haldean/droidcopter/text/spring/figures/firstrunpngs/motor1.png

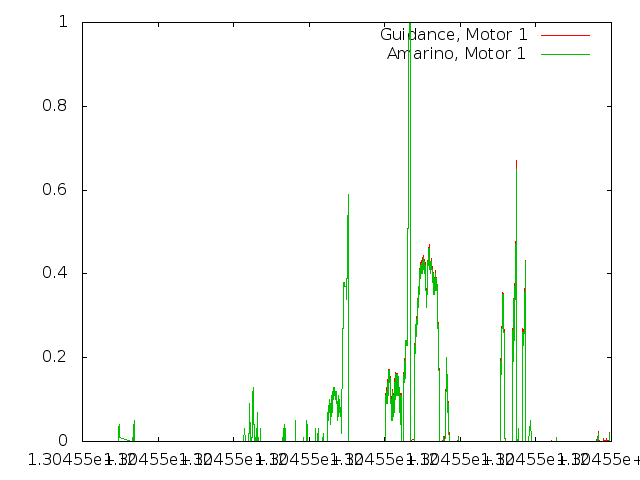
text/spring/figures/firstrunpngs/motor1.png
