haldean/droidcopter/text/spring/figures/firstrunpngs/motor3.png

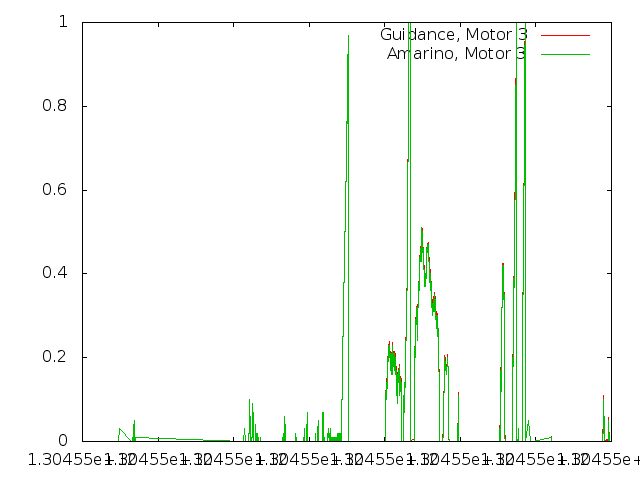
text/spring/figures/firstrunpngs/motor3.png
