haldean/droidcopter/models/stl/stanley.stl

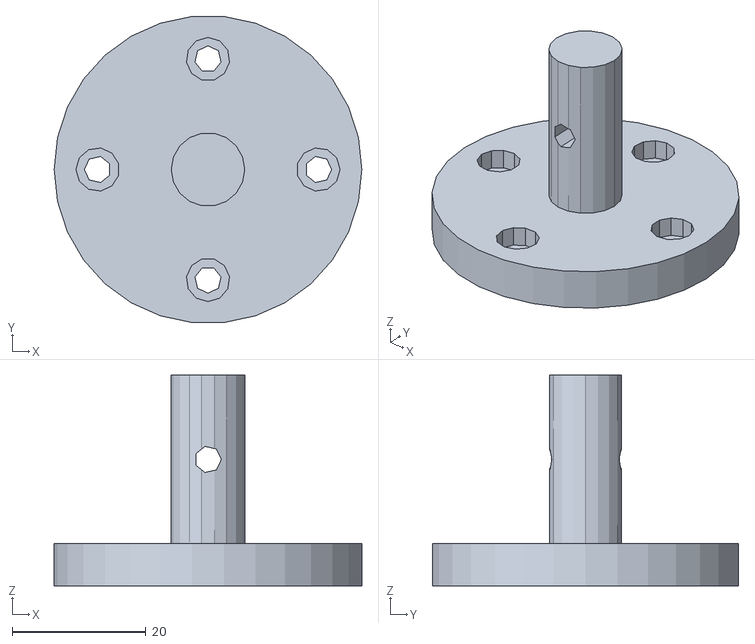
[picture p12: CAD file, 2010-12-11]
models/stl/stanley.stl
46.0 x 45.7 x 31.5
