haldean/droidcopter/models/stl/fred_extended.stl

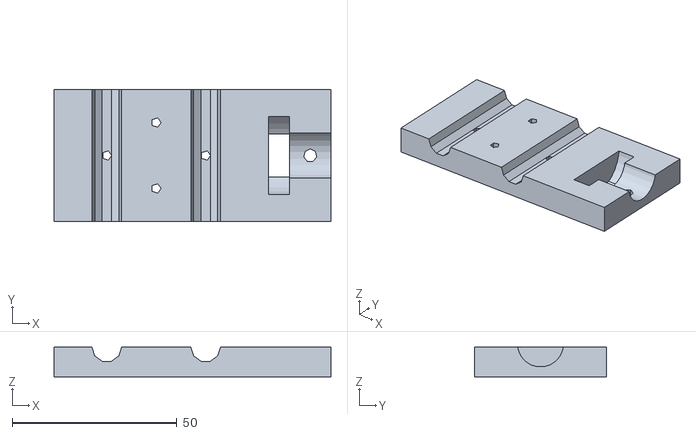
[picture p13: CAD file, 2010-11-23]
models/stl/fred_extended.stl
84.0 x 40.0 x 9.00
