haldean/droidcopter/models/stl/benedict.stl

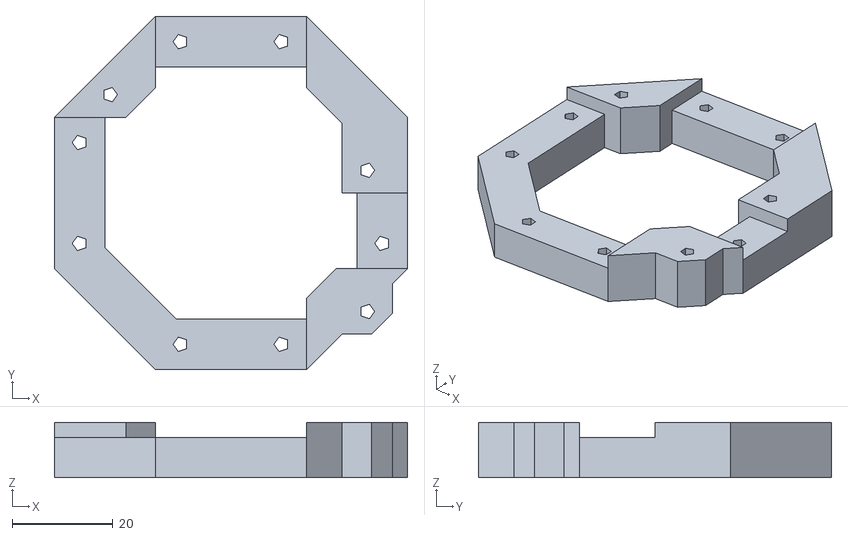
[picture p14: CAD file, 2010-11-23]
models/stl/benedict.stl
70.0 x 70.0 x 11.0
