haldean/droidcopter/models/stl/brock_a.stl

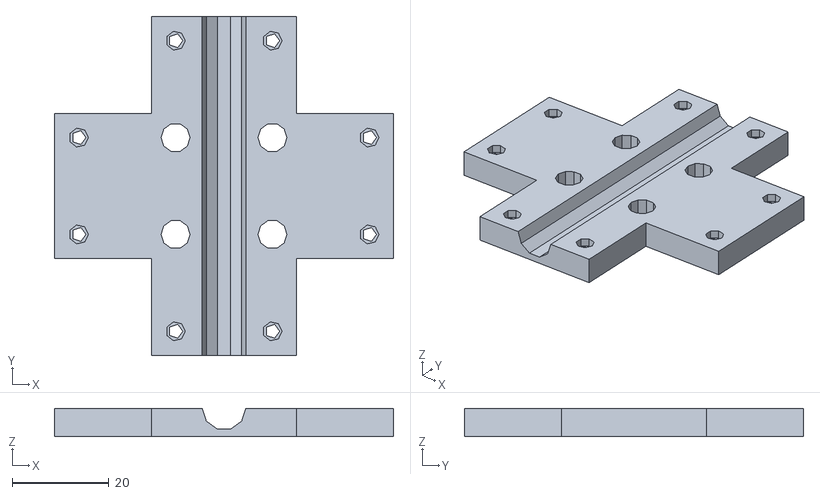
[picture p15: CAD file, 2010-11-23]
models/stl/brock_a.stl
70.0 x 70.0 x 5.85
