haldean/droidcopter/models/stl/brock_b.stl

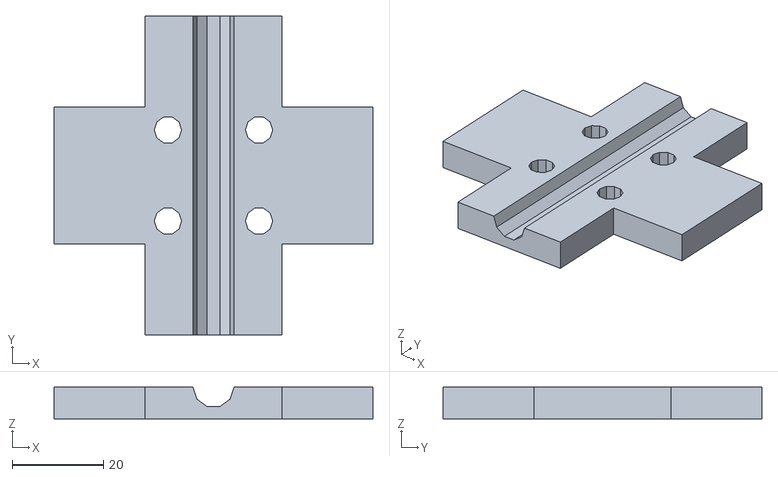
[picture p16: CAD file, 2010-11-23]
models/stl/brock_b.stl
70.0 x 70.0 x 7.00
