haldean/droidcopter/models/stl/fred.stl

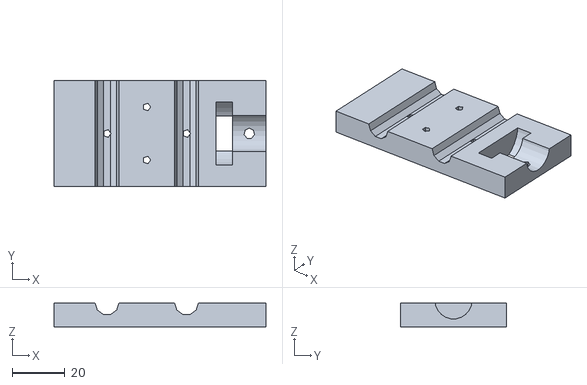
[picture p17: CAD file, 2010-11-23]
models/stl/fred.stl
80.0 x 40.0 x 9.00
