haldean/droidcopter/models/scad/fred_extended.scad

include <hardware.scad>
use <stanley.scad>

module fred() {
	h = 2 * axle_r;
	extension = 4; 
	difference() {
		cube([80 + extension, 40, h]);

		translate(v=[20 - extension, -10, h]) axlepair();

		translate(v=[80 + extension, 20, 10]) {
			rotate(v=[1,0,0], 90) 
				rotate(v=[0,1,0], 90) stanley(solid_screw=true);
		}

		for (v = [[20 - extension + axle_separation/2, 10, 0],
				[20 - extension + axle_separation/2, 30, 0]])
			translate(v=v) m2();

		for (v = [[20 - extension,20,0],
				[20 - extension + axle_separation,20,0]])
			translate(v=v) m2();
	}
}

fred();
