haldean/droidcopter/(list of files, cad)

Other CAD files:
models/scad/axle.scad
models/scad/brock_a.scad
models/scad/brock_b.scad
