haldean/droidcopter/jars/worldwind/src/gov/nasa/worldwind/layers/AbstractGraticuleLayer.java

/*
Copyright (C) 2001, 2009 United States Government
as represented by the Administrator of the
National Aeronautics and Space Administration.
All Rights Reserved.
*/
package gov.nasa.worldwind.layers;

import gov.nasa.worldwind.View;
import gov.nasa.worldwind.avlist.*;
import gov.nasa.worldwind.geom.*;
import gov.nasa.worldwind.globes.Globe;
import gov.nasa.worldwind.render.*;
import gov.nasa.worldwind.util.*;
import gov.nasa.worldwind.view.orbit.OrbitView;

import java.awt.*;
import java.util.*;

/**
 * Displays a graticule.
 *
 * @author Patrick Murris
 * @version $Id$
 */
public class AbstractGraticuleLayer extends AbstractLayer
{
    /**
     * Solid line rendering style. This style specifies that a line will be drawn without any breaks. <br>
     * <pre><code>_________</code></pre>
     * <br> is an example of a solid line.
     */
    public static final String LINE_STYLE_SOLID = GraticuleRenderingParams.VALUE_LINE_STYLE_SOLID;
    /**
     * Dashed line rendering style. This style specifies that a line will be drawn as a series of long strokes, with
     * space in between. <br>
     * <pre><code>- - - - -</code></pre>
     * <br> is an example of a dashed line.
     */
    public static final String LINE_STYLE_DASHED = GraticuleRenderingParams.VALUE_LINE_STYLE_DASHED;
    /**
     * Dotted line rendering style. This style specifies that a line will be drawn as a series of evenly spaced "square"
     * dots. <br>
     * <pre><code>. . . . .</code></pre>
     * is an example of a dotted line.
     */
    public static final String LINE_STYLE_DOTTED = GraticuleRenderingParams.VALUE_LINE_STYLE_DOTTED;

    protected ArrayList<GridElement> gridElements;
    protected GraticuleSupport graticuleSupport = new GraticuleSupport();
    protected double polylineTerrainConformance = 50;
    protected Frustum viewFrustum;
    protected Globe globe;
    protected boolean useSurfaceShapes = false; // TODO: Set to true for Surface polyline test

    // Update reference states
    protected Vec4 lastEyePoint;
    protected double lastViewHeading = 0;
    protected double lastViewPitch = 0;
    protected double lastViewFOV = 0;
    protected double lastVerticalExaggeration = 1;

    public AbstractGraticuleLayer()
    {
    }

    /**
     * Returns whether or not graticule lines will be rendered.
     *
     * @param key the rendering parameters key.
     *
     * @return true if graticule lines will be rendered; false otherwise.
     *
     * @throws IllegalArgumentException <code>key</code> is null.
     */
    public boolean isDrawGraticule(String key)
    {
        if (key == null)
        {
            String message = Logging.getMessage("nullValue.StringIsNull");
            Logging.logger().severe(message);
            throw new IllegalArgumentException(message);
        }
        return getRenderingParams(key).isDrawLines();
    }

    /**
     * Sets whether or not graticule lines will be rendered.
     *
     * @param drawGraticule true to render graticule lines; false to disable rendering.
     * @param key           the rendering parameters key.
     *
     * @throws IllegalArgumentException <code>key</code> is null.
     */
    public void setDrawGraticule(boolean drawGraticule, String key)
    {
        if (key == null)
        {
            String message = Logging.getMessage("nullValue.StringIsNull");
            Logging.logger().severe(message);
            throw new IllegalArgumentException(message);
        }
        getRenderingParams(key).setDrawLines(drawGraticule);
    }

    /**
     * Returns the graticule line Color.
     *
     * @param key the rendering parameters key.
     *
     * @return Color used to render graticule lines.
     *
     * @throws IllegalArgumentException <code>key</code> is null.
     */
    public Color getGraticuleLineColor(String key)
    {
        if (key == null)
        {
            String message = Logging.getMessage("nullValue.StringIsNull");
            Logging.logger().severe(message);
            throw new IllegalArgumentException(message);
        }
        return getRenderingParams(key).getLineColor();
    }

    /**
     * Sets the graticule line Color.
     *
     * @param color Color that will be used to render graticule lines.
     * @param key   the rendering parameters key.
     *
     * @throws IllegalArgumentException if <code>color</code> or <code>key</code> is null.
     */
    public void setGraticuleLineColor(Color color, String key)
    {
        if (color == null)
        {
            String message = Logging.getMessage("nullValue.ColorIsNull");
            Logging.logger().severe(message);
            throw new IllegalArgumentException(message);
        }
        if (key == null)
        {
            String message = Logging.getMessage("nullValue.StringIsNull");
            Logging.logger().severe(message);
            throw new IllegalArgumentException(message);
        }

        getRenderingParams(key).setLineColor(color);
    }

    /**
     * Returns the graticule line width.
     *
     * @param key the rendering parameters key.
     *
     * @return width of the graticule lines.
     *
     * @throws IllegalArgumentException <code>key</code> is null.
     */
    public double getGraticuleLineWidth(String key)
    {
        if (key == null)
        {
            String message = Logging.getMessage("nullValue.StringIsNull");
            Logging.logger().severe(message);
            throw new IllegalArgumentException(message);
        }
        return getRenderingParams(key).getLineWidth();
    }

    /**
     * Sets the graticule line width.
     *
     * @param lineWidth width of the graticule lines.
     * @param key       the rendering parameters key.
     *
     * @throws IllegalArgumentException <code>key</code> is null.
     */
    public void setGraticuleLineWidth(double lineWidth, String key)
    {
        if (key == null)
        {
            String message = Logging.getMessage("nullValue.StringIsNull");
            Logging.logger().severe(message);
            throw new IllegalArgumentException(message);
        }
        getRenderingParams(key).setLineWidth(lineWidth);
    }

    /**
     * Returns the graticule line rendering style.
     *
     * @param key the rendering parameters key.
     *
     * @return rendering style of the graticule lines.
     *
     * @throws IllegalArgumentException <code>key</code> is null.
     */
    public String getGraticuleLineStyle(String key)
    {
        if (key == null)
        {
            String message = Logging.getMessage("nullValue.StringIsNull");
            Logging.logger().severe(message);
            throw new IllegalArgumentException(message);
        }
        return getRenderingParams(key).getLineStyle();
    }

    /**
     * Sets the graticule line rendering style.
     *
     * @param lineStyle rendering style of the graticule lines. One of LINE_STYLE_PLAIN, LINE_STYLE_DASHED, or
     *                  LINE_STYLE_DOTTED.
     * @param key       the rendering parameters key.
     *
     * @throws IllegalArgumentException if <code>lineStyle</code> or <code>key</code> is null.
     */
    public void setGraticuleLineStyle(String lineStyle, String key)
    {
        if (lineStyle == null)
        {
            String message = Logging.getMessage("nullValue.StringIsNull");
            Logging.logger().severe(message);
            throw new IllegalArgumentException(message);
        }
        if (key == null)
        {
            String message = Logging.getMessage("nullValue.StringIsNull");
            Logging.logger().severe(message);
            throw new IllegalArgumentException(message);
        }

        getRenderingParams(key).setLineStyle(lineStyle);
    }

    /**
     * Returns whether or not graticule labels will be rendered.
     *
     * @param key the rendering parameters key.
     *
     * @return true if graticule labels will be rendered; false otherwise.
     *
     * @throws IllegalArgumentException <code>key</code> is null.
     */
    public boolean isDrawLabels(String key)
    {
        if (key == null)
        {
            String message = Logging.getMessage("nullValue.StringIsNull");
            Logging.logger().severe(message);
            throw new IllegalArgumentException(message);
        }
        return getRenderingParams(key).isDrawLabels();
    }

    /**
     * Sets whether or not graticule labels will be rendered.
     *
     * @param drawLabels true to render graticule labels; false to disable rendering.
     * @param key        the rendering parameters key.
     *
     * @throws IllegalArgumentException <code>key</code> is null.
     */
    public void setDrawLabels(boolean drawLabels, String key)
    {
        if (key == null)
        {
            String message = Logging.getMessage("nullValue.StringIsNull");
            Logging.logger().severe(message);
            throw new IllegalArgumentException(message);
        }
        getRenderingParams(key).setDrawLabels(drawLabels);
    }

    /**
     * Returns the graticule label Color.
     *
     * @param key the rendering parameters key.
     *
     * @return Color used to render graticule labels.
     *
     * @throws IllegalArgumentException <code>key</code> is null.
     */
    public Color getLabelColor(String key)
    {
        if (key == null)
        {
            String message = Logging.getMessage("nullValue.StringIsNull");
            Logging.logger().severe(message);
            throw new IllegalArgumentException(message);
        }
        return getRenderingParams(key).getLabelColor();
    }

    /**
     * Sets the graticule label Color.
     *
     * @param color Color that will be used to render graticule labels.
     * @param key   the rendering parameters key.
     *
     * @throws IllegalArgumentException if <code>color</code> or <code>key</code> is null.
     */
    public void setLabelColor(Color color, String key)
    {
        if (color == null)
        {
            String message = Logging.getMessage("nullValue.ColorIsNull");
            Logging.logger().severe(message);
            throw new IllegalArgumentException(message);
        }
        if (key == null)
        {
            String message = Logging.getMessage("nullValue.StringIsNull");
            Logging.logger().severe(message);
            throw new IllegalArgumentException(message);
        }

        getRenderingParams(key).setLabelColor(color);
    }

    /**
     * Returns the Font used for graticule labels.
     *
     * @param key the rendering parameters key.
     *
     * @return Font used to render graticule labels.
     *
     * @throws IllegalArgumentException <code>key</code> is null.
     */
    public Font getLabelFont(String key)
    {
        if (key == null)
        {
            String message = Logging.getMessage("nullValue.StringIsNull");
            Logging.logger().severe(message);
            throw new IllegalArgumentException(message);
        }
        return getRenderingParams(key).getLabelFont();
    }

    /**
     * Sets the Font used for graticule labels.
     *
     * @param font Font that will be used to render graticule labels.
     * @param key  the rendering parameters key.
     *
     * @throws IllegalArgumentException if <code>font</code> or <code>key</code> is null.
     */
    public void setLabelFont(Font font, String key)
    {
        if (font == null)
        {
            String message = Logging.getMessage("nullValue.FontIsNull");
            Logging.logger().severe(message);
            throw new IllegalArgumentException(message);
        }
        if (key == null)
        {
            String message = Logging.getMessage("nullValue.StringIsNull");
            Logging.logger().severe(message);
            throw new IllegalArgumentException(message);
        }

        getRenderingParams(key).setLabelFont(font);
    }

    public String getRestorableState()
    {
        RestorableSupport rs = RestorableSupport.newRestorableSupport();
        // Creating a new RestorableSupport failed. RestorableSupport logged the problem, so just return null.
        if (rs == null)
            return null;

        RestorableSupport.StateObject so = rs.addStateObject("renderingParams");
        for (Map.Entry<String, GraticuleRenderingParams> entry : this.graticuleSupport.getAllRenderingParams())
        {
            if (entry.getKey() != null && entry.getValue() != null)
            {
                RestorableSupport.StateObject eso = rs.addStateObject(so, entry.getKey());
                makeRestorableState(entry.getValue(), rs, eso);
            }
        }

        return rs.getStateAsXml();
    }

    private static void makeRestorableState(AVList params, RestorableSupport rs, RestorableSupport.StateObject context)
    {
        if (params != null && rs != null)
        {
            for (Map.Entry<String, Object> p : params.getEntries())
            {
                if (p.getValue() instanceof Color)
                {
                    rs.addStateValueAsInteger(context, p.getKey() + ".Red", ((Color) p.getValue()).getRed());
                    rs.addStateValueAsInteger(context, p.getKey() + ".Green", ((Color) p.getValue()).getGreen());
                    rs.addStateValueAsInteger(context, p.getKey() + ".Blue", ((Color) p.getValue()).getBlue());
                    rs.addStateValueAsInteger(context, p.getKey() + ".Alpha", ((Color) p.getValue()).getAlpha());
                }
                else if (p.getValue() instanceof Font)
                {
                    rs.addStateValueAsString(context, p.getKey() + ".Name", ((Font) p.getValue()).getName());
                    rs.addStateValueAsInteger(context, p.getKey() + ".Style", ((Font) p.getValue()).getStyle());
                    rs.addStateValueAsInteger(context, p.getKey() + ".Size", ((Font) p.getValue()).getSize());
                }
                else
                {
                    rs.addStateValueAsString(context, p.getKey(), p.getValue().toString());
                }
            }
        }
    }

    public void restoreState(String stateInXml)
    {
        if (stateInXml == null)
        {
            String message = Logging.getMessage("nullValue.StringIsNull");
            Logging.logger().severe(message);
            throw new IllegalArgumentException(message);
        }

        RestorableSupport rs;
        try
        {
            rs = RestorableSupport.parse(stateInXml);
        }
        catch (Exception e)
        {
            // Parsing the document specified by stateInXml failed.
            String message = Logging.getMessage("generic.ExceptionAttemptingToParseStateXml", stateInXml);
            Logging.logger().severe(message);
            throw new IllegalArgumentException(message, e);
        }

        RestorableSupport.StateObject so = rs.getStateObject("renderingParams");
        if (so != null)
        {
            RestorableSupport.StateObject[] renderParams = rs.getAllStateObjects(so);
            for (RestorableSupport.StateObject rp : renderParams)
            {
                if (rp != null)
                {
                    GraticuleRenderingParams params = getRenderingParams(rp.getName());
                    if (params == null)
                        params = new GraticuleRenderingParams();
                    restorableStateToParams(params, rs, rp);
                    setRenderingParams(rp.getName(), params);
                }
            }
        }
    }

    private static void restorableStateToParams(AVList params, RestorableSupport rs,
        RestorableSupport.StateObject context)
    {
        if (params != null && rs != null)
        {
            Boolean b = rs.getStateValueAsBoolean(context, GraticuleRenderingParams.KEY_DRAW_LINES);
            if (b != null)
                params.setValue(GraticuleRenderingParams.KEY_DRAW_LINES, b);

            Integer red = rs.getStateValueAsInteger(context, GraticuleRenderingParams.KEY_LINE_COLOR + ".Red");
            Integer green = rs.getStateValueAsInteger(context, GraticuleRenderingParams.KEY_LINE_COLOR + ".Green");
            Integer blue = rs.getStateValueAsInteger(context, GraticuleRenderingParams.KEY_LINE_COLOR + ".Blue");
            Integer alpha = rs.getStateValueAsInteger(context, GraticuleRenderingParams.KEY_LINE_COLOR + ".Alpha");
            if (red != null && green != null && blue != null && alpha != null)
                params.setValue(GraticuleRenderingParams.KEY_LINE_COLOR, new Color(red, green, blue, alpha));

            Double d = rs.getStateValueAsDouble(context, GraticuleRenderingParams.KEY_LINE_WIDTH);
            if (d != null)
                params.setValue(GraticuleRenderingParams.KEY_LINE_WIDTH, d);

            String s = rs.getStateValueAsString(context, GraticuleRenderingParams.KEY_LINE_STYLE);
            if (s != null)
                params.setValue(GraticuleRenderingParams.KEY_LINE_STYLE, s);

            b = rs.getStateValueAsBoolean(context, GraticuleRenderingParams.KEY_DRAW_LABELS);
            if (b != null)
                params.setValue(GraticuleRenderingParams.KEY_DRAW_LABELS, b);

            red = rs.getStateValueAsInteger(context, GraticuleRenderingParams.KEY_LABEL_COLOR + ".Red");
            green = rs.getStateValueAsInteger(context, GraticuleRenderingParams.KEY_LABEL_COLOR + ".Green");
            blue = rs.getStateValueAsInteger(context, GraticuleRenderingParams.KEY_LABEL_COLOR + ".Blue");
            alpha = rs.getStateValueAsInteger(context, GraticuleRenderingParams.KEY_LABEL_COLOR + ".Alpha");
            if (red != null && green != null && blue != null && alpha != null)
                params.setValue(GraticuleRenderingParams.KEY_LABEL_COLOR, new Color(red, green, blue, alpha));

            String name = rs.getStateValueAsString(context, GraticuleRenderingParams.KEY_LABEL_FONT + ".Name");
            Integer style = rs.getStateValueAsInteger(context, GraticuleRenderingParams.KEY_LABEL_FONT + ".Style");
            Integer size = rs.getStateValueAsInteger(context, GraticuleRenderingParams.KEY_LABEL_FONT + ".Size");
            if (name != null && style != null && size != null)
                params.setValue(GraticuleRenderingParams.KEY_LABEL_FONT, new Font(name, style, size));
        }
    }

    // --- Graticule Rendering --------------------------------------------------------------

    protected GraticuleRenderingParams getRenderingParams(String key)
    {
        if (key == null)
        {
            String message = Logging.getMessage("nullValue.KeyIsNull");
            Logging.logger().severe(message);
            throw new IllegalArgumentException(message);
        }

        return this.graticuleSupport.getRenderingParams(key);
    }

    protected void setRenderingParams(String key, GraticuleRenderingParams renderingParams)
    {
        if (key == null)
        {
            String message = Logging.getMessage("nullValue.KeyIsNull");
            Logging.logger().severe(message);
            throw new IllegalArgumentException(message);
        }

        this.graticuleSupport.setRenderingParams(key, renderingParams);
    }

    protected void addRenderable(Object renderable, String paramsKey)
    {
        if (renderable == null)
        {
            String message = Logging.getMessage("nullValue.ObjectIsNull");
            Logging.logger().severe(message);
            throw new IllegalArgumentException(message);
        }

        this.graticuleSupport.addRenderable(renderable, paramsKey);
    }

    protected void removeAllRenderables()
    {
        this.graticuleSupport.removeAllRenderables();
    }

    public void doPreRender(DrawContext dc)
    {
        if (dc == null)
        {
            String message = Logging.getMessage("nullValue.DrawContextIsNull");
            Logging.logger().severe(message);
            throw new IllegalArgumentException(message);
        }
        if (this.needsToUpdate(dc))
        {
            // Init frame
            this.clear(dc);

            // Select renderables
            this.selectRenderables(dc);
        }
        // Pre render
        this.preRenderGraticule(dc);
    }

    public void doRender(DrawContext dc)
    {
        if (dc == null)
        {
            String message = Logging.getMessage("nullValue.DrawContextIsNull");
            Logging.logger().severe(message);
            throw new IllegalArgumentException(message);
        }

        // Render
        this.renderGraticule(dc);
    }

    protected void preRenderGraticule(DrawContext dc)
    {
        if (dc == null)
        {
            String message = Logging.getMessage("nullValue.DrawContextIsNull");
            Logging.logger().severe(message);
            throw new IllegalArgumentException(message);
        }

        this.graticuleSupport.preRender(dc, this.getOpacity());
    }

    protected void renderGraticule(DrawContext dc)
    {
        if (dc == null)
        {
            String message = Logging.getMessage("nullValue.DrawContextIsNull");
            Logging.logger().severe(message);
            throw new IllegalArgumentException(message);
        }

        this.graticuleSupport.render(dc, this.getOpacity());
    }

    /**
     * Select the visible grid elements
     *
     * @param dc the current <code>DrawContext</code>.
     */
    protected void selectRenderables(DrawContext dc)
    {
        if (dc == null)
        {
            String message = Logging.getMessage("nullValue.DrawContextIsNull");
            Logging.logger().severe(message);
            throw new IllegalArgumentException(message);
        }

        // This method is intended to be overriden by subclasses

    }

    /**
     * Determines whether the grid should be updated. It returns true if: <ul> <li>the eye has moved more than 1% of its
     * altitude above ground <li>the view FOV, heading or pitch have changed more than 1 degree <li>vertical
     * exaggeration has changed </ul
     *
     * @param dc the current <code>DrawContext</code>.
     *
     * @return true if the graticule should be updated.
     */
    @SuppressWarnings({"RedundantIfStatement"})
    protected boolean needsToUpdate(DrawContext dc)
    {
        if (this.lastEyePoint == null)
            return true;

        View view = dc.getView();
        double altitudeAboveGround = computeAltitudeAboveGround(dc);
        if (view.getEyePoint().distanceTo3(this.lastEyePoint) > altitudeAboveGround / 100)  // 1% of AAG
            return true;

        if (this.lastVerticalExaggeration != dc.getVerticalExaggeration())
            return true;

        if (Math.abs(this.lastViewHeading - view.getHeading().degrees) > 1)
            return true;
        if (Math.abs(this.lastViewPitch - view.getPitch().degrees) > 1)
            return true;

        if (Math.abs(this.lastViewFOV - view.getFieldOfView().degrees) > 1)
            return true;

        return false;
    }

    protected void clear(DrawContext dc)
    {
        this.removeAllRenderables();
        this.polylineTerrainConformance = computeTerrainConformance(dc);
        this.viewFrustum = dc.getView().getFrustumInModelCoordinates();
        this.globe = dc.getGlobe();
        this.lastEyePoint = dc.getView().getEyePoint();
        this.lastViewFOV = dc.getView().getFieldOfView().degrees;
        this.lastViewHeading = dc.getView().getHeading().degrees;
        this.lastViewPitch = dc.getView().getPitch().degrees;
        this.lastVerticalExaggeration = dc.getVerticalExaggeration();
    }

    protected double computeTerrainConformance(DrawContext dc)
    {
        int value = 100;
        double alt = dc.getView().getEyePosition().getElevation();
        if (alt < 10e3)
            value = 20;
        else if (alt < 50e3)
            value = 30;
        else if (alt < 100e3)
            value = 40;
        else if (alt < 1000e3)
            value = 60;

        return value;
    }

    protected LatLon computeLabelOffset(DrawContext dc)
    {
        LatLon labelPos;
        // Compute labels offset from view center
        if (dc.getView() instanceof OrbitView)
        {
            OrbitView view = (OrbitView) dc.getView();
            Position centerPos = view.getCenterPosition();
            Double pixelSizeDegrees = Angle.fromRadians(view.computePixelSizeAtDistance(view.getZoom())
                / dc.getGlobe().getEquatorialRadius()).degrees;
            Double labelOffsetDegrees = pixelSizeDegrees * view.getViewport().getWidth() / 4;
            labelPos = LatLon.fromDegrees(centerPos.getLatitude().degrees - labelOffsetDegrees,
                centerPos.getLongitude().degrees - labelOffsetDegrees);
            Double labelLatDegrees = labelPos.getLatitude().normalizedLatitude().degrees;
            labelLatDegrees = Math.min(Math.max(labelLatDegrees, -70), 70);
            labelPos = new LatLon(Angle.fromDegrees(labelLatDegrees), labelPos.getLongitude().normalizedLongitude());
        }
        else
            labelPos = dc.getView().getEyePosition(); // fall back if no orbit view

        return labelPos;
    }

    protected Object createLineRenderable(Iterable<? extends LatLon> positions, int pathType)
    {
        Object renderable;
        if (this.useSurfaceShapes)
        {
            SurfacePolyline polyline = new SurfacePolyline(positions);
            polyline.setPathType(pathType == Polyline.LINEAR ? AVKey.LINEAR : AVKey.GREAT_CIRCLE);
            renderable = polyline;
        }
        else
        {
            Polyline polyline = new Polyline(positions, 0);
            polyline.setPathType(pathType);
            polyline.setFollowTerrain(true);
            polyline.setTerrainConformance(50);
            renderable = polyline;
        }
        return renderable;
    }

    protected class GridElement
    {
        public final static String TYPE_LINE = "GridElement_Line";
        public final static String TYPE_LINE_NORTH = "GridElement_LineNorth";
        public final static String TYPE_LINE_SOUTH = "GridElement_LineSouth";
        public final static String TYPE_LINE_WEST = "GridElement_LineWest";
        public final static String TYPE_LINE_EAST = "GridElement_LineEast";
        public final static String TYPE_LINE_NORTHING = "GridElement_LineNorthing";
        public final static String TYPE_LINE_EASTING = "GridElement_LineEasting";
        public final static String TYPE_GRIDZONE_LABEL = "GridElement_GridZoneLabel";
        public final static String TYPE_LONGITUDE_LABEL = "GridElement_LongitudeLabel";
        public final static String TYPE_LATITUDE_LABEL = "GridElement_LatitudeLabel";

        public final Sector sector;
        public final Object renderable;
        public final String type;
        public double value;

        public GridElement(Sector sector, Object renderable, String type)
        {
            if (sector == null)
            {
                String message = Logging.getMessage("nullValue.SectorIsNull");
                Logging.logger().severe(message);
                throw new IllegalArgumentException(message);
            }
            if (renderable == null)
            {
                String message = Logging.getMessage("nullValue.ObjectIsNull");
                Logging.logger().severe(message);
                throw new IllegalArgumentException(message);
            }
            if (type == null)
            {
                String message = Logging.getMessage("nullValue.StringIsNull");
                Logging.logger().severe(message);
                throw new IllegalArgumentException(message);
            }
            this.sector = sector;
            this.renderable = renderable;
            this.type = type;
        }

        public void setValue(double value)
        {
            this.value = value;
        }

        public boolean isInView(DrawContext dc)
        {
            if (dc == null)
            {
                String message = Logging.getMessage("nullValue.DrawContextIsNull");
                Logging.logger().severe(message);
                throw new IllegalArgumentException(message);
            }
            return isInView(dc, dc.getVisibleSector());
        }

        @SuppressWarnings({"RedundantIfStatement"})
        public boolean isInView(DrawContext dc, Sector vs)
        {
            if (dc == null)
            {
                String message = Logging.getMessage("nullValue.DrawContextIsNull");
                Logging.logger().severe(message);
                throw new IllegalArgumentException(message);
            }
            if (vs == null)
            {
                String message = Logging.getMessage("nullValue.SectorIsNull");
                Logging.logger().severe(message);
                throw new IllegalArgumentException(message);
            }
            if (!this.sector.intersects(vs))
                return false;

            return true;
        }
    }

    // === Support methods ===

    protected Vec4 getSurfacePoint(DrawContext dc, Angle latitude, Angle longitude)
    {
        Vec4 surfacePoint = dc.getSurfaceGeometry().getSurfacePoint(latitude, longitude);
        if (surfacePoint == null)
            surfacePoint = dc.getGlobe().computePointFromPosition(new Position(latitude, longitude,
                dc.getGlobe().getElevation(latitude, longitude)));

        return surfacePoint;
    }

    protected double computeAltitudeAboveGround(DrawContext dc)
    {
        View view = dc.getView();
        Position eyePosition = view.getEyePosition();
        Vec4 surfacePoint = getSurfacePoint(dc, eyePosition.getLatitude(), eyePosition.getLongitude());

        return view.getEyePoint().distanceTo3(surfacePoint);
    }

    protected void computeTruncatedSegment(Position p1, Position p2, Sector sector, ArrayList<Position> positions)
    {
        if (p1 == null || p2 == null)
            return;

        boolean p1In = sector.contains(p1);
        boolean p2In = sector.contains(p2);
        if (!p1In && !p2In)
        {
            // whole segment is (likely) outside
            return;
        }
        if (p1In && p2In)
        {
            // whole segment is (likely) inside
            positions.add(p1);
            positions.add(p2);
        }
        else
        {
            // segment does cross the boundary
            Position outPoint = !p1In ? p1 : p2;
            Position inPoint = p1In ? p1 : p2;
            for (int i = 1; i <= 2; i++)  // there may be two intersections
            {
                LatLon intersection = null;
                if (outPoint.getLongitude().degrees > sector.getMaxLongitude().degrees
                    || (sector.getMaxLongitude().degrees == 180 && outPoint.getLongitude().degrees < 0))
                {
                    // intersect with east meridian
                    intersection = greatCircleIntersectionAtLongitude(
                        inPoint, outPoint, sector.getMaxLongitude());
                }
                else if (outPoint.getLongitude().degrees < sector.getMinLongitude().degrees
                    || (sector.getMinLongitude().degrees == -180 && outPoint.getLongitude().degrees > 0))
                {
                    // intersect with west meridian
                    intersection = greatCircleIntersectionAtLongitude(
                        inPoint, outPoint, sector.getMinLongitude());
                }
                else if (outPoint.getLatitude().degrees > sector.getMaxLatitude().degrees)
                {
                    // intersect with top parallel
                    intersection = greatCircleIntersectionAtLatitude(
                        inPoint, outPoint, sector.getMaxLatitude());
                }
                else if (outPoint.getLatitude().degrees < sector.getMinLatitude().degrees)
                {
                    // intersect with bottom parallel
                    intersection = greatCircleIntersectionAtLatitude(
                        inPoint, outPoint, sector.getMinLatitude());
                }
                if (intersection != null)
                    outPoint = new Position(intersection, outPoint.getElevation());
                else
                    break;
            }
            positions.add(inPoint);
            positions.add(outPoint);
        }
    }

    /**
     * Computes the intersection point position between a great circle segment and a meridian.
     *
     * @param p1        the great circle segment start position.
     * @param p2        the great circle segment end position.
     * @param longitude the meridian longitude <code>Angle</code>
     *
     * @return the intersection <code>Position</code> or null if there was no intersection found.
     */
    protected LatLon greatCircleIntersectionAtLongitude(LatLon p1, LatLon p2, Angle longitude)
    {
        if (p1.getLongitude().degrees == longitude.degrees)
            return p1;
        if (p2.getLongitude().degrees == longitude.degrees)
            return p2;
        LatLon pos = null;
        Double deltaLon = getDeltaLongitude(p1, p2.getLongitude()).degrees;
        if (getDeltaLongitude(p1, longitude).degrees < deltaLon
            && getDeltaLongitude(p2, longitude).degrees < deltaLon)
        {
            int count = 0;
            double precision = 1d / 6378137d; // 1m angle in radians
            LatLon a = p1;
            LatLon b = p2;
            LatLon midPoint = greatCircleMidPoint(a, b);
            while (getDeltaLongitude(midPoint, longitude).radians > precision && count <= 20)
            {
                count++;
                if (getDeltaLongitude(a, longitude).degrees < getDeltaLongitude(b, longitude).degrees)
                    b = midPoint;
                else
                    a = midPoint;
                midPoint = greatCircleMidPoint(a, b);
            }
            pos = midPoint;
            //if (count >= 20)
            //    System.out.println("Warning dichotomy loop aborted: " + p1 + " - " + p2 + " for lon " + longitude + " = " + pos);
        }
        // Adjust final longitude for an exact match
        if (pos != null)
            pos = new LatLon(pos.getLatitude(), longitude);
        return pos;
    }

    /**
     * Computes the intersection point position between a great circle segment and a parallel.
     *
     * @param p1       the great circle segment start position.
     * @param p2       the great circle segment end position.
     * @param latitude the parallel latitude <code>Angle</code>
     *
     * @return the intersection <code>Position</code> or null if there was no intersection found.
     */
    protected LatLon greatCircleIntersectionAtLatitude(LatLon p1, LatLon p2, Angle latitude)
    {
        LatLon pos = null;
        if (Math.signum(p1.getLatitude().degrees - latitude.degrees)
            != Math.signum(p2.getLatitude().degrees - latitude.degrees))
        {
            int count = 0;
            double precision = 1d / 6378137d; // 1m angle in radians
            LatLon a = p1;
            LatLon b = p2;
            LatLon midPoint = greatCircleMidPoint(a, b);
            while (Math.abs(midPoint.getLatitude().radians - latitude.radians) > precision && count <= 20)
            {
                count++;
                if (Math.signum(a.getLatitude().degrees - latitude.degrees)
                    != Math.signum(midPoint.getLatitude().degrees - latitude.degrees))
                    b = midPoint;
                else
                    a = midPoint;
                midPoint = greatCircleMidPoint(a, b);
            }
            pos = midPoint;
            //if (count >= 20)
            //    System.out.println("Warning dichotomy loop aborted: " + p1 + " - " + p2 + " for lat " + latitude + " = " + pos);
        }
        // Adjust final latitude for an exact match
        if (pos != null)
            pos = new LatLon(latitude, pos.getLongitude());
        return pos;
    }

    protected LatLon greatCircleMidPoint(LatLon p1, LatLon p2)
    {
        Angle azimuth = LatLon.greatCircleAzimuth(p1, p2);
        Angle distance = LatLon.greatCircleDistance(p1, p2);
        return LatLon.greatCircleEndPosition(p1, azimuth.radians, distance.radians / 2);
    }

    protected Angle getDeltaLongitude(LatLon p1, Angle longitude)
    {
        double deltaLon = Math.abs(p1.getLongitude().degrees - longitude.degrees);
        return Angle.fromDegrees(deltaLon < 180 ? deltaLon : 360 - deltaLon);
    }
}
