haldean/droidcopter/(commit log)

2010-07-03 Combine codebases
    [AppConfiguration.xml, Hipparcos_Stars_Mag6x5044.tsv]
2010-07-06 Comm tweaks: added commenting, altered lock on establish-connection thread initialization
2010-07-25 Debug PID loop (X-Y accidental switch tentatively fixed)
    [Guidance.java]
2010-10-09 Reluctantly adding eclipse project data, just in case.
2010-10-24 Added models, changed to use new broker server.
    [axle.scad, fred.scad, hardware.scad]
2010-10-25 Code implemented to rotate acceleration vector to absolute frame, integrate into velocity. HARDWARE NOT SUFFICIENTLY RELIABLE TO IMPLEMENT THIS.
2010-10-25 Added Heartbeat, more model detail
    [brock.scad, fred.scad, fred.stl, fred_demo.scad, hardware.scad, stanley.scad]
2010-10-25 Telemetry resize fixed; binaries removed
    [ChopperStatus.java]
2010-10-25 Heartbeat working, round trip times printed to debug output.
2010-10-28 Updated TODO to reflect current progress.
2010-10-28 Updated models, ready to print
    [brock.scad, brock_a.stl, brock_b.stl, fred.scad, fred.stl, fred_demo.scad, hardware.scad]
2010-11-03 Updated models -- printing now
    [brock_a.scad, brock_a.stl, brock_b.scad, brock_b.stl, fred.scad, fred.stl]
2010-11-06 Implemented heartbeat; implemented ability to change PID tuning values from server
2010-11-10 build_v1 models finalized, arduino mount completed
    [arduino.scad, benedict.scad, benedict.stl, brock_a.scad, brock_a.stl, brock_b.scad, brock_b.stl, fred.scad]
2010-11-23 Guidance accpets manual motor vectors
2010-11-27 Added some firmware tests and basic Bluetooth implementation
    [droid.scad, droidmount.scad]
2010-11-28 Update Navigator to allow sending PID values, and remove snarky comment that was only there because of my inability to read documentation.
2010-11-28 Add a PID Error component with graphs of the various PID errors.
2010-11-28 Code pruning in PID error component.
2010-11-28 Added a frame for adjusting tuning parameters in the chopper. Not particularly useful until you can get the parameters out, as well.
2010-11-28 Quick fixes to make MotorComponent easier.
2010-11-28 Add MotorComponent, which, for now, can only set speeds, not read them (because we don't get speeds from the chopper).
2010-11-28 Increased Heartbeat timer; fixed pilot code. Needs testing.
2010-11-28 Fixed nav docs; added get-PID functionality to Guidance
    [Constants.java, Guidance.java]
2010-11-28 Added motor battery levels to ChopperStatus
2010-11-28 Changed MotorComponent to use TextFields, and PidTuningComponent now makes it clear which loop is which.
2010-12-06 Added PidLogger to log PID values, accelerations and motor speeds.
2010-12-06 Hooked up MotorComponent using the brand-new message hook system.
2010-12-11 Added updated models for motor mounts.
    [stanley.scad, stanley.stl]
2011-01-23 Guidance interprets navigation targets in the local frame of reference when navigation is in manual mode.
2011-01-23 Added velocity and target radius to WorldWindComponent
2011-01-23 Allow setting velocity without changing bearing in EnsignCrusher
2011-01-23 Server processes velocity vector from 360 controller
2011-01-23 Server doesn't send pointless vectors from 360 controller
    [Guidance.java]
2011-01-24 PadController's 0-filtering improved
2011-01-24 Added public interface to controller buttons and axes.
2011-01-31 We don't need to track debug output
2011-01-31 Added model demos (which I should have done a month ago)
    [brock_demo.scad, fred_demo.scad]
2011-02-05 Removed PersistentThread usage; doesn't crash when application focus is lost/restored
    [ChopperStatus.java, Guidance.java]
2011-03-07 Update firmware for better stability at low speeds.
    [firmware.pde]
2011-03-26 Updated BlobTracker thread to actually work correctly.
2011-03-27 Updated firmware to work with new motor controllers
2011-04-16 Finished padcontroller bearing reading; Debugged direct control of motor speeds
2011-04-16 light calibration of guidance
2011-05-04 PrEmbarassing bugfixes; ana kleine preliminary tuning
    [ChopperStatus.java, Guidance.java]
2011-05-04 Figures for paper; Some guidance PID updates; small bugfix
    [Guidance.java]
2011-07-25 New PID loop/guidance structure (EnsignCrusher updated). Fixed bug in PadController where the back button would not be recognized.
    [ChopperStatus.java, Guidance.java, StatusReporter.java]
2011-08-23 Adding unit tests for Guidance.
    [proguard.cfg]
2011-08-30 Fixed eclipse project inclusion/exclusion rules.
    [ChopperStatusImpl.java]
2011-08-30 Fix hypothetically-possible divide by zero problems, that would probably never have come up ever.
    [ChopperStatusImpl.java, Guidance.java]
2011-09-18 Spring essay updated
2012-08-24 fixed eclipse nonsense; minor UI changes to Amarino for ICS compatibility; reset control vars on PID update; set guidance loop to 30Hz
    [ChopperStatusImpl.java, Guidance.java]
2013-01-22 Adds PID Tuner.
